smileym4n-collab/CoolCubeLM1875/CoolCubeLM1875kicad_pro/CoolCubeLM1875kicad_pro.kicad_pcb

## KiCad design CoolCubeLM1875kicad_pro/CoolCubeLM1875kicad_pro.kicad_pcb (2026-08-13)

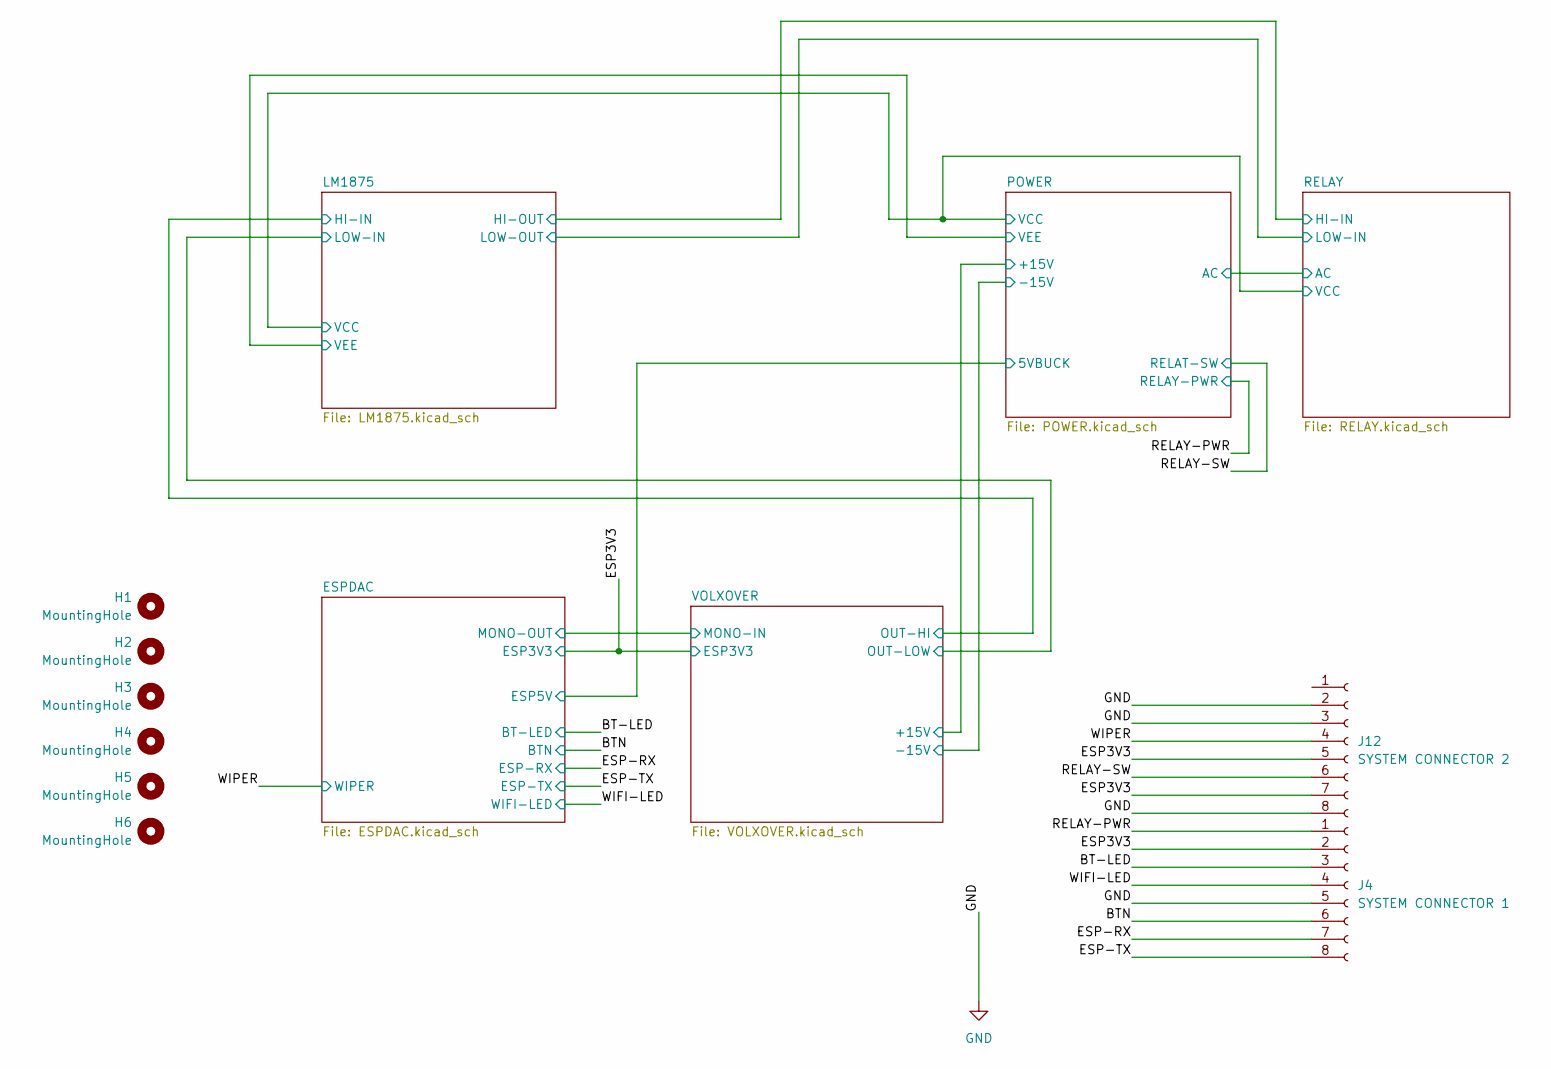
[picture p1: schematic CoolCubeLM1875kicad_pro.kicad_sch]

Parts:
H1, H2, H3, H4, H5, H6: MountingHole; MountingHole_4mm
J4: SYSTEM CONNECTOR 1; JST_XH_B8B-XH-A_1x08_P2.50mm_Vertical
J12: SYSTEM CONNECTOR 2; JST_XH_B8B-XH-A_1x08_P2.50mm_Vertical

Connections:
/BT-LED: J4.3; also elsewhere on the board
/BTN: J4.6; also elsewhere on the board
/ESP3V3: J4.2, J12.5, J12.7; also elsewhere on the board
/ESP-RX: J4.7; also elsewhere on the board
/ESP-TX: J4.8; also elsewhere on the board
/RELAY-PWR: J4.1; also elsewhere on the board
/RELAY-SW: J12.6; also elsewhere on the board
/WIFI-LED: J4.4; also elsewhere on the board
/WIPER: J12.4; also elsewhere on the board
GND: J4.5, J12.2, J12.3, J12.8; also elsewhere on the board

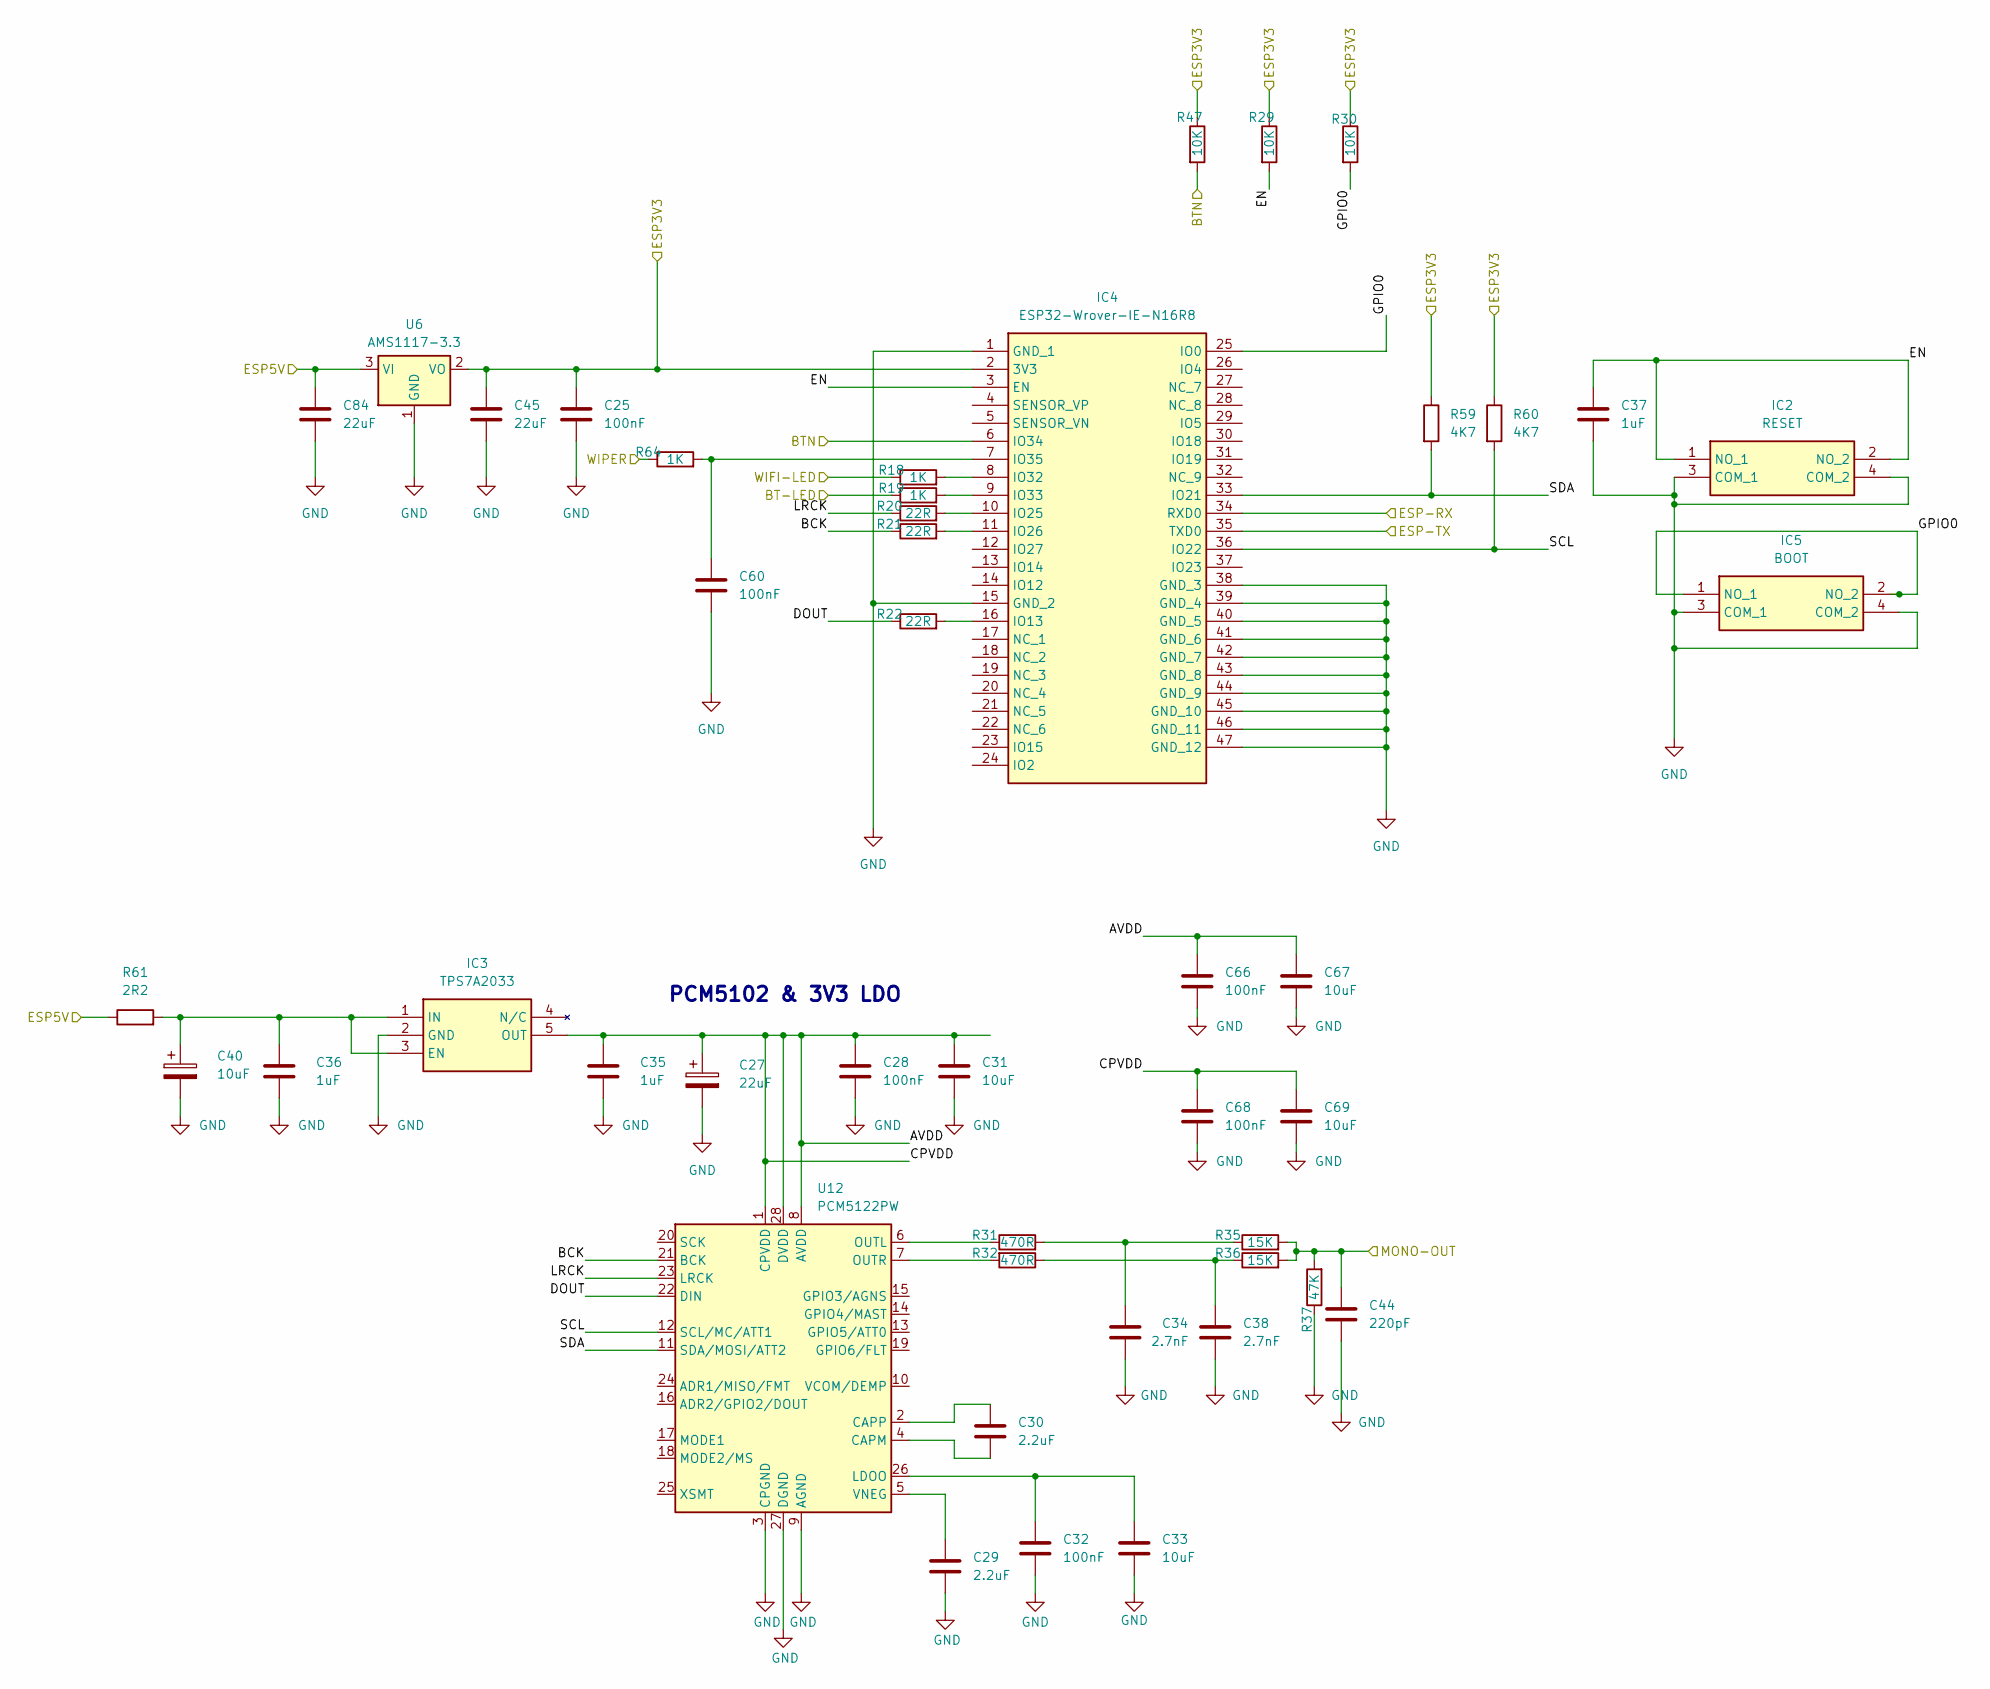
[picture p2: schematic ESPDAC.kicad_sch]

Parts:
C25, C28, C32, C60, C66, C68: 100nF; C_1206_3216Metric_Pad1.33x1.80mm_HandSolder
C27: 22uF; CP_Radial_D5.0mm_P2.50mm
C29, C30: 2.2uF; C_0805_2012Metric_Pad1.18x1.45mm_HandSolder
C31, C67, C69: 10uF; C_0805_2012Metric_Pad1.18x1.45mm_HandSolder
C33: 10uF; C_1206_3216Metric_Pad1.33x1.80mm_HandSolder
C34, C38: 2.7nF; C_0805_2012Metric_Pad1.18x1.45mm_HandSolder
C35, C36, C37: 1uF; C_1206_3216Metric_Pad1.33x1.80mm_HandSolder
C40: 10uF; CP_Radial_D4.0mm_P1.50mm
C44: 220pF; C_0603_1608Metric_Pad1.08x0.95mm_HandSolder
C45, C84: 22uF; C_0805_2012Metric_Pad1.18x1.45mm_HandSolder
IC2: RESET; TS026650BK100SCRD; Mouser Part Number 179-TS026650BK100SCR
IC3: TPS7A2033; SOT95P280X145-5N; Mouser Part Number 595-TPS7A2033PDBVR
IC4: ESP32-Wrover-IE-N16R8; ESP32-WROVER-IE-N16R8; Mouser Part Number 356-ESP32WRVIE2864UC
IC5: BOOT; TS026650BK100SCRD; Mouser Part Number 179-TS026650BK100SCR
R18, R19, R64: 1K; R_0805_2012Metric_Pad1.20x1.40mm_HandSolder
R20, R21, R22: 22R; R_0603_1608Metric_Pad0.98x0.95mm_HandSolder
R29, R30, R47: 10K; R_0603_1608Metric_Pad0.98x0.95mm_HandSolder
R31, R32: 470R; R_0805_2012Metric_Pad1.20x1.40mm_HandSolder
R35, R36: 15K; R_0805_2012Metric_Pad1.20x1.40mm_HandSolder
R37: 47K; R_0805_2012Metric_Pad1.20x1.40mm_HandSolder
R59, R60: 4K7; R_0805_2012Metric_Pad1.20x1.40mm_HandSolder
R61: 2R2; R_0805_2012Metric_Pad1.20x1.40mm_HandSolder
U6: AMS1117-3.3; SOT-223-3_TabPin2
U12: PCM5122PW; TSSOP-28_4.4x9.7mm_P0.65mm

Connections:
/BT-LED: R19.1; also elsewhere on the board
/BTN: IC4.6 (IO34), R47.2; also elsewhere on the board
/ESP3V3: C25.1, C45.1, IC4.2 (3V3), R29.1, R30.1, R47.1, R59.1, R60.1, U6.2 (VO); also elsewhere on the board
/ESP-RX: IC4.34 (RXD0); also elsewhere on the board
/ESP-TX: IC4.35 (TXD0); also elsewhere on the board
/ESPDAC/AVDD: C27.1, C28.1, C31.1, C35.1, C66.1, C67.1, C68.1, C69.1, IC3.5 (OUT), U12.1 (CPVDD), U12.8 (AVDD), U12.28 (DVDD)
/ESPDAC/BCK: R21.1, U12.21 (BCK)
/ESPDAC/DOUT: R22.1, U12.22 (DIN)
/ESPDAC/EN: C37.1, IC2.1 (NO_1), IC2.2 (NO_2), IC4.3 (EN), R29.2
/ESPDAC/ESP5V: C84.1, R61.1, U6.3 (VI); also elsewhere on the board
/ESPDAC/GPIO0: IC4.25 (IO0), IC5.1 (NO_1), IC5.2 (NO_2), R30.2
/ESPDAC/LRCK: R20.1, U12.23 (LRCK)
/ESPDAC/MONO-OUT: C44.1, R35.2, R36.2, R37.2; also elsewhere on the board
/ESPDAC/SCL: IC4.36 (IO22), R60.2, U12.12 (SCL/MC/ATT1)
/ESPDAC/SDA: IC4.33 (IO21), R59.2, U12.11 (SDA/MOSI/ATT2)
/WIFI-LED: R18.1; also elsewhere on the board
/WIPER: R64.1; also elsewhere on the board
GND: C25.2, C27.2, C28.2, C29.2, C31.2, C32.2, C33.2, C34.2, C35.2, C36.2, C37.2, C38.2, C40.2, C44.2, C45.2, C60.2, C66.2, C67.2, C68.2, C69.2, C84.2, IC2.3 (COM_1), IC2.4 (COM_2), IC3.2 (GND), IC4.1 (GND_1), IC4.15 (GND_2), IC4.38 (GND_3), IC4.39 (GND_4), IC4.40 (GND_5), IC4.41 (GND_6), IC4.42 (GND_7), IC4.43 (GND_8), IC4.44 (GND_9), IC4.45 (GND_10), IC4.46 (GND_11), IC4.47 (GND_12), IC5.3 (COM_1), IC5.4 (COM_2), R37.1, U6.1 (GND), U12.3 (CPGND), U12.9 (AGND), U12.27 (DGND); also elsewhere on the board
unnamed: C34.1, R31.2, R35.1
unnamed: C38.1, R32.1, R36.1
unnamed: C36.1, C40.1, IC3.1 (IN), IC3.3 (EN), R61.2
unnamed: IC4.16 (IO13), R22.2
unnamed: IC4.10 (IO25), R20.2
unnamed: IC4.11 (IO26), R21.2
unnamed: IC4.8 (IO32), R18.2
unnamed: IC4.9 (IO33), R19.2
unnamed: C60.1, IC4.7 (IO35), R64.2
unnamed: C30.2, U12.4 (CAPM)
unnamed: C30.1, U12.2 (CAPP)
unnamed: C32.1, C33.1, U12.26 (LDOO)
unnamed: R31.1, U12.6 (OUTL)
unnamed: R32.2, U12.7 (OUTR)
unnamed: C29.1, U12.5 (VNEG)

Notes on the sheet:
PCM5102 & 3V3 LDO

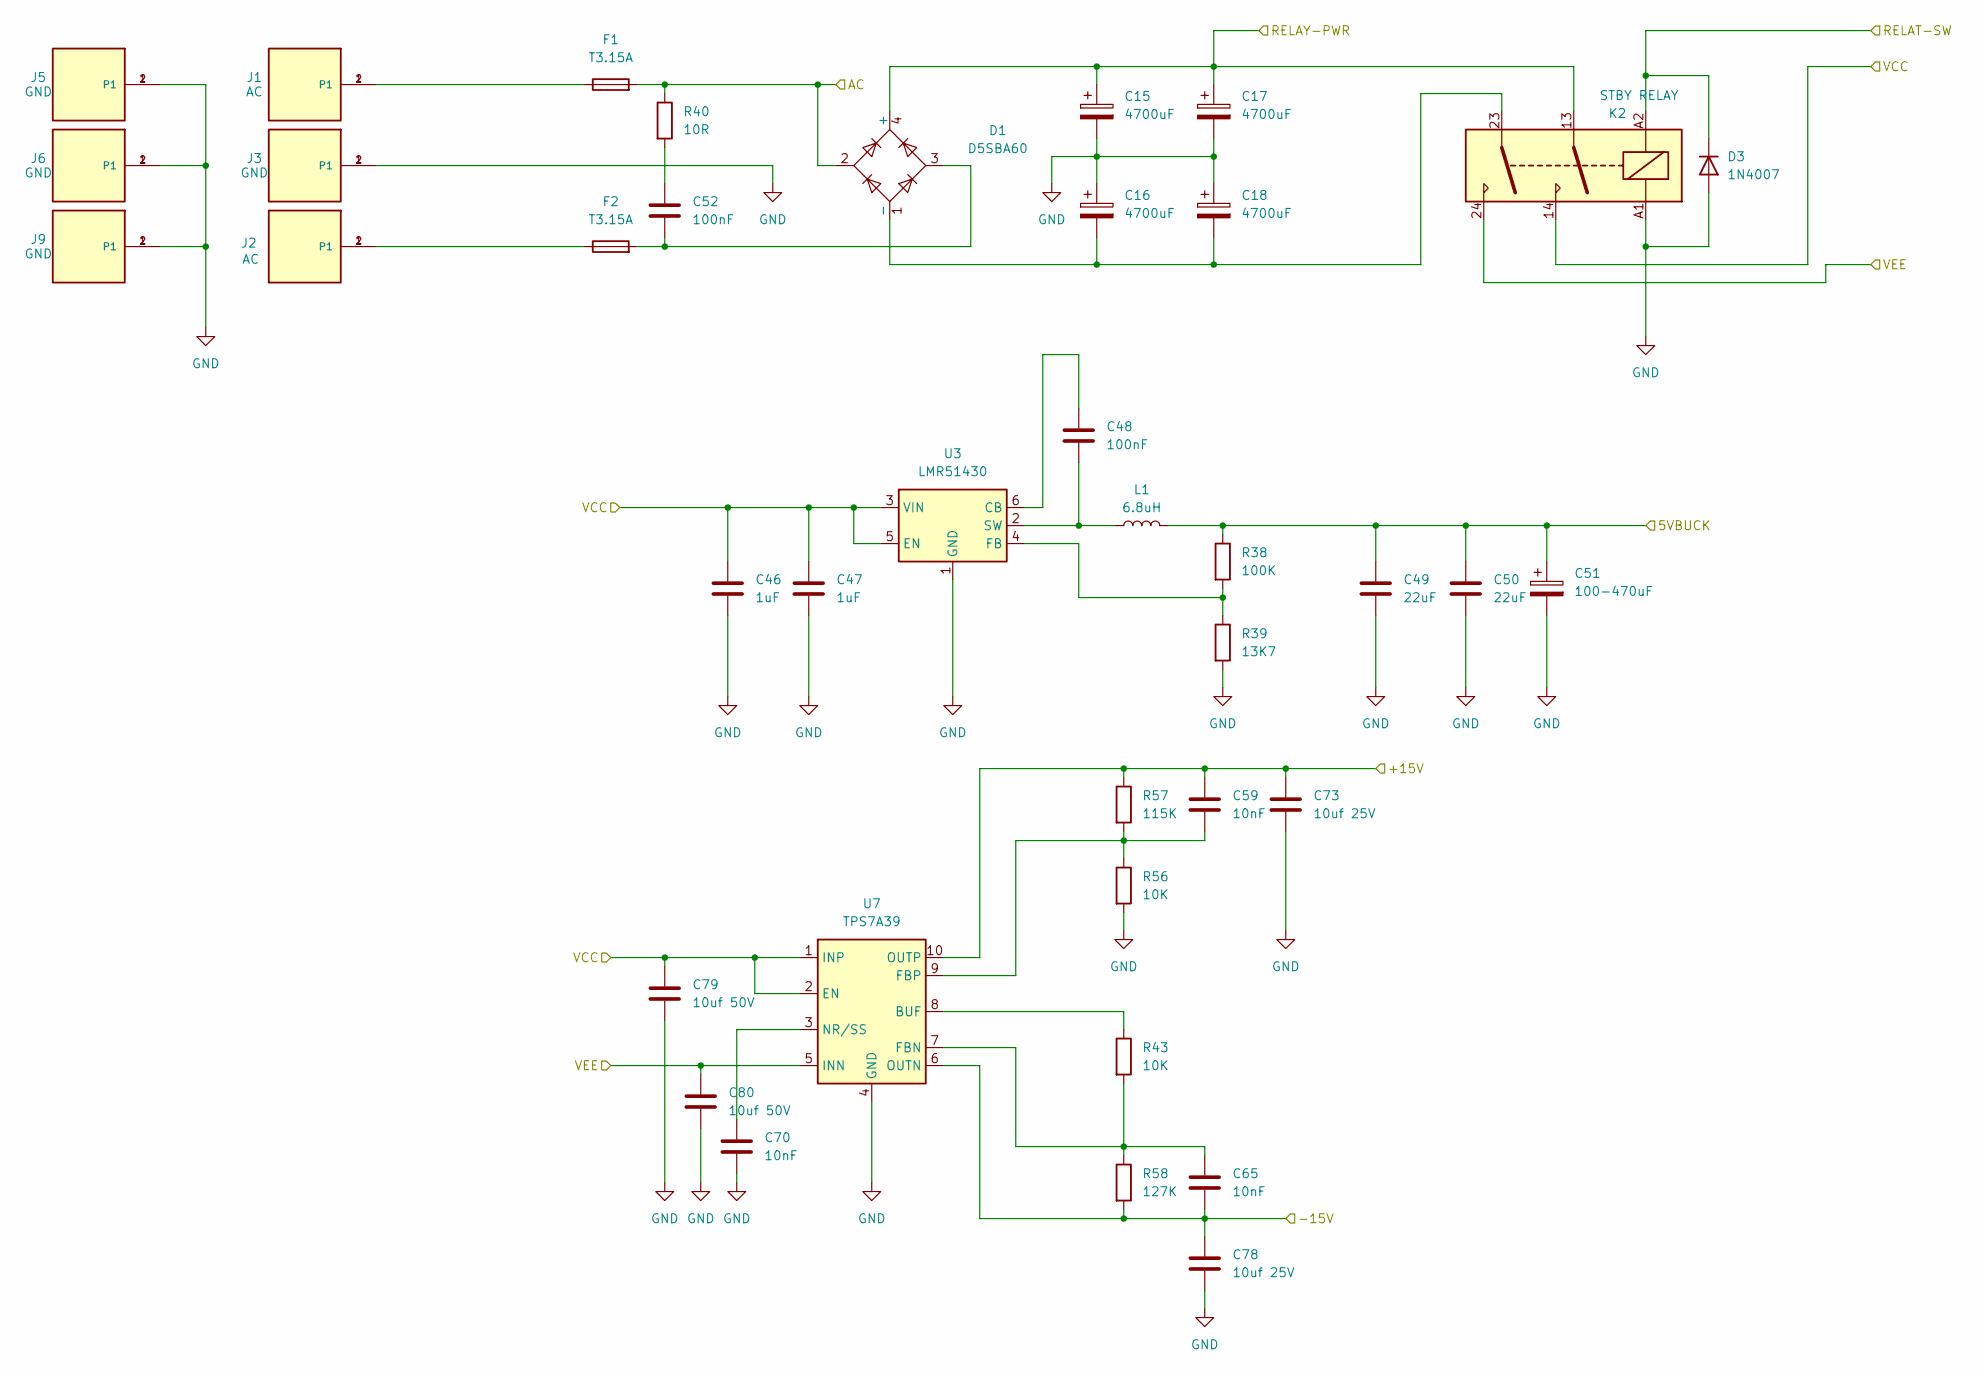
[picture p3: schematic POWER.kicad_sch]

Parts:
C15, C16, C17, C18: 4700uF; CP_Radial_D22.0mm_P10.00mm_SnapIn
C46, C47: 1uF; C_1206_3216Metric_Pad1.33x1.80mm_HandSolder
C48: 100nF; C_1206_3216Metric_Pad1.33x1.80mm_HandSolder
C49, C50: 22uF; C_1206_3216Metric_Pad1.33x1.80mm_HandSolder
C51: 100-470uF; CP_Radial_D8.0mm_P3.50mm
C52: 100nF; C_Rect_L18.0mm_W5.0mm_P15.00mm_FKS3_FKP3
C59, C65, C70: 10nF; C_0805_2012Metric_Pad1.18x1.45mm_HandSolder
C73, C78: 10uf 25V; C_1206_3216Metric_Pad1.33x1.80mm_HandSolder
C79, C80: 10uf 50V; C_1206_3216Metric_Pad1.33x1.80mm_HandSolder
D1: D5SBA60; Diode_Bridge_32.0x5.6x17.0mm_P10.0mm_P7.5mm
D3: 1N4007; D_DO-41_SOD81_P10.16mm_Horizontal
F1, F2: T3.15A; Fuseholder_Cylinder-5x20mm_Schurter_0031_8201_Horizontal_Op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
J1, J2: AC; TE_62409-1; PART_DESCRIPTION CONN QC TAB 0.250 SOLDER
J3, J5, J6, J9: GND; TE_62409-1; PART_DESCRIPTION CONN QC TAB 0.250 SOLDER
K2: STBY RELAY; Relay_DPST_Omron_G2RL-2A
L1: 6.8uH; SRP6030WA-6R8M
R38: 100K; R_0805_2012Metric_Pad1.20x1.40mm_HandSolder
R39: 13K7; R_0805_2012Metric_Pad1.20x1.40mm_HandSolder
R40: 10R; R_Axial_DIN0617_L17.0mm_D6.0mm_P20.32mm_Horizontal
R43, R56: 10K; R_0805_2012Metric_Pad1.20x1.40mm_HandSolder
R57: 115K; R_0805_2012Metric_Pad1.20x1.40mm_HandSolder
R58: 127K; R_0805_2012Metric_Pad1.20x1.40mm_HandSolder
U3: LMR51430; SOT-23-6_Handsoldering
U7: TPS7A39; Texas_S-PVSON-N10_ThermalVias

Connections:
/ESPDAC/ESP5V: C49.1, C50.1, C51.1, L1.2, R38.1; also elsewhere on the board
/LM1875/VCC: C46.1, C47.1, C79.1, K2.14, U3.3 (VIN), U3.5 (EN), U7.1 (INP), U7.2 (EN); also elsewhere on the board
/LM1875/VEE: C80.1, K2.24, U7.5 (INN); also elsewhere on the board
/POWER/+15V: C59.1, C73.1, R57.1, U7.10 (OUTP); also elsewhere on the board
/POWER/-15V: C65.2, C78.1, R58.2, U7.6 (OUTN); also elsewhere on the board
/POWER/AC: D1.2, F1.2, R40.1; also elsewhere on the board
/RELAY-PWR: C15.1, C17.1, D1.4 (+), K2.13; also elsewhere on the board
/RELAY-SW: D3.1 (K), K2.A2; also elsewhere on the board
GND: C15.2, C16.1, C17.2, C18.1, C46.2, C47.2, C49.2, C50.2, C51.2, C70.2, C73.2, C78.2, C79.2, C80.2, D3.2 (A), J3.1, J3.2 (P1), J5.1, J5.2 (P1), J6.1, J6.2 (P1), J9.1, J9.2 (P1), K2.A1, R39.2, R56.2, U3.1 (GND), U7.4 (GND), U7.11 (GND); also elsewhere on the board
unnamed: C52.1, R40.2
unnamed: C52.2, D1.3, F2.2
unnamed: C16.2, C18.2, D1.1 (-), K2.23
unnamed: F1.1, J1.1, J1.2 (P1)
unnamed: F2.1, J2.1, J2.2 (P1)
unnamed: C48.1, U3.6 (CB)
unnamed: R38.2, R39.1, U3.4 (FB)
unnamed: C48.2, L1.1, U3.2 (SW)
unnamed: R43.1, U7.8 (BUF)
unnamed: C65.1, R43.2, R58.1, U7.7 (FBN)
unnamed: C59.2, R56.1, R57.2, U7.9 (FBP)
unnamed: C70.1, U7.3 (NR/SS)

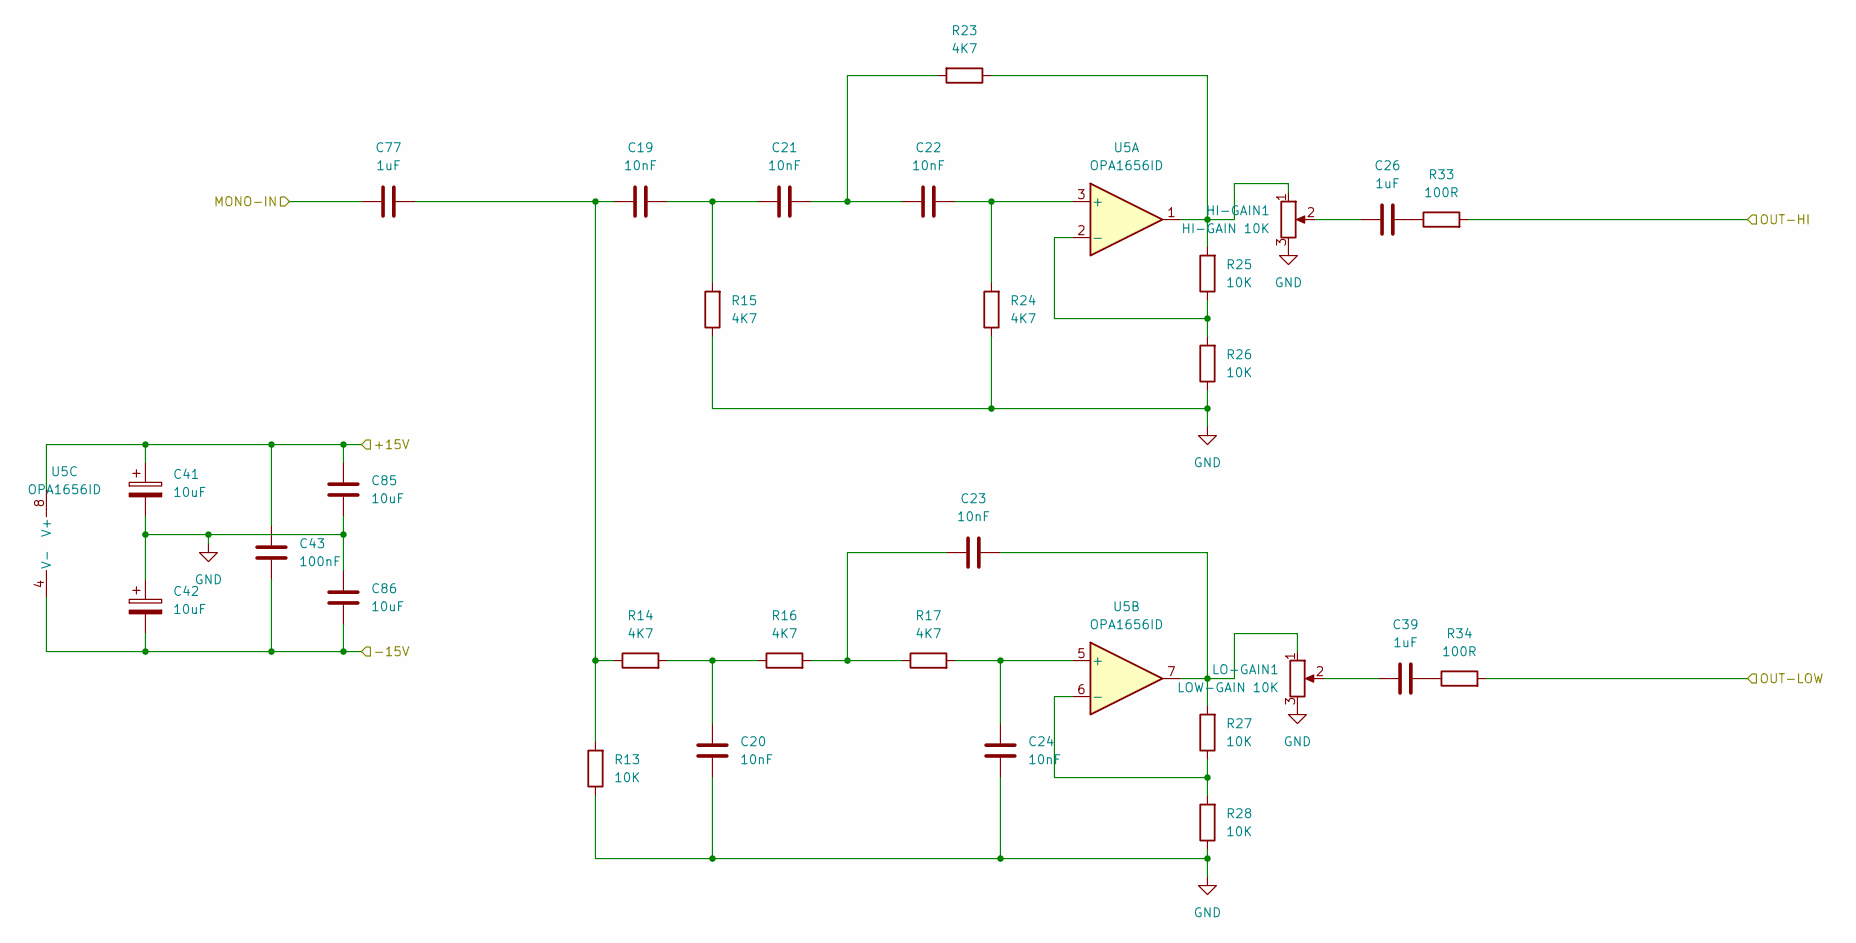
[picture p4: schematic VOLXOVER.kicad_sch]

Parts:
C19, C20, C21, C22, C23, C24: 10nF; C_0805_2012Metric_Pad1.18x1.45mm_HandSolder
C26, C39, C77: 1uF; C_Rect_L7.2mm_W5.5mm_P5.00mm_FKS2_FKP2_MKS2_MKP2
C41, C42: 10uF; CP_Radial_D5.0mm_P2.50mm
C43: 100nF; C_1206_3216Metric_Pad1.33x1.80mm_HandSolder
C85, C86: 10uF; C_1206_3216Metric_Pad1.33x1.80mm_HandSolder
HI-GAIN1: HI-GAIN 10K; Potentiometer_Vishay_T93YA_Vertical
LO-GAIN1: LOW-GAIN 10K; Potentiometer_Vishay_T93YA_Vertical
R13, R25, R26, R27, R28: 10K; R_0805_2012Metric_Pad1.20x1.40mm_HandSolder
R14, R15, R16, R17, R23, R24: 4K7; R_0805_2012Metric_Pad1.20x1.40mm_HandSolder
R33, R34: 100R; R_0805_2012Metric_Pad1.20x1.40mm_HandSolder
U5: OPA1656ID; SOIC-8_3.9x4.9mm_P1.27mm

Connections:
/ESPDAC/MONO-OUT: C77.1; also elsewhere on the board
/LM1875/HI-IN: R33.2; also elsewhere on the board
/LM1875/LOW-IN: R34.2; also elsewhere on the board
/POWER/+15V: C41.1, C43.1, C85.1, U5.8 (V+); also elsewhere on the board
/POWER/-15V: C42.2, C43.2, C86.2, U5.4 (V-); also elsewhere on the board
GND: C20.1, C24.1, C41.2, C42.1, C85.2, C86.1, HI-GAIN1.3, LO-GAIN1.3, R13.1, R15.1, R24.1, R26.1, R28.1; also elsewhere on the board
unnamed: C19.1, C77.2, R13.2, R14.1
unnamed: C19.2, C21.1, R15.2
unnamed: C20.2, R14.2, R16.1
unnamed: C21.2, C22.1, R23.2
unnamed: C23.1, R16.2, R17.1
unnamed: C23.2, LO-GAIN1.1, R27.2, U5.7
unnamed: C26.1, HI-GAIN1.2
unnamed: C26.2, R33.1
unnamed: C39.1, LO-GAIN1.2
unnamed: C39.2, R34.1
unnamed: HI-GAIN1.1, R23.1, R25.2, U5.1
unnamed: C22.2, R24.2, U5.3 (+)
unnamed: R25.1, R26.2, U5.2 (-)
unnamed: C24.2, R17.2, U5.5 (+)
unnamed: R27.1, R28.2, U5.6 (-)

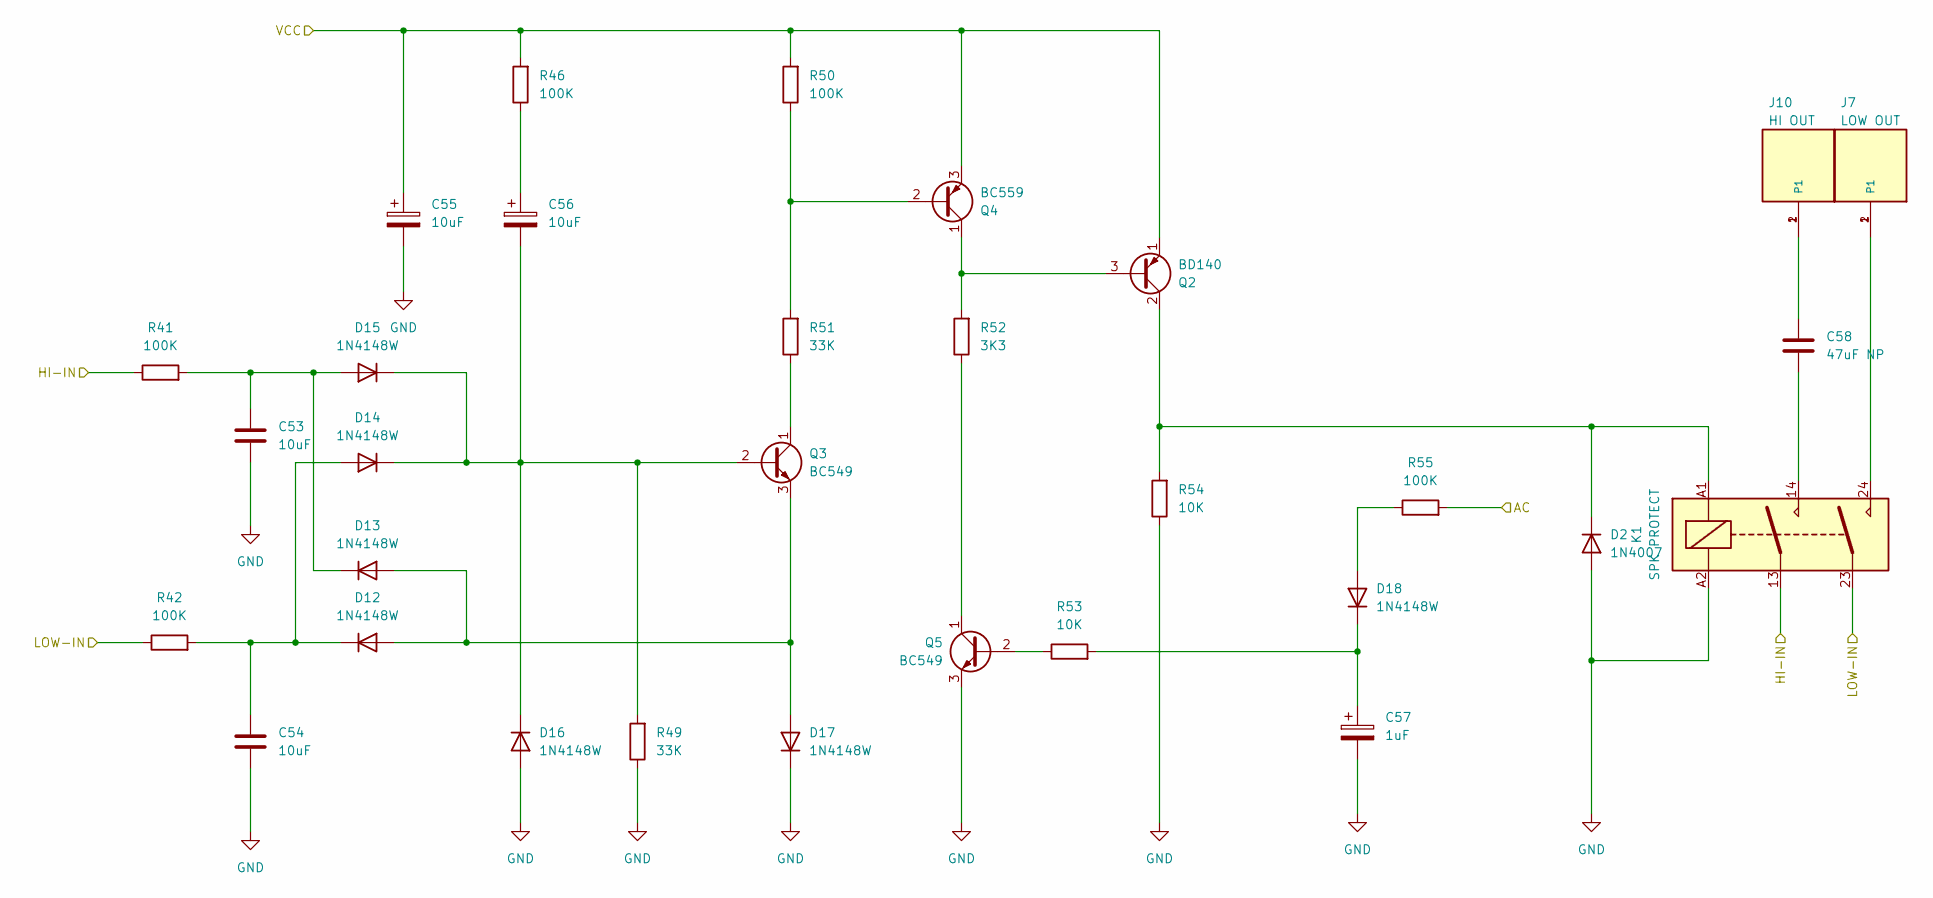
[picture p5: schematic RELAY.kicad_sch]

Parts:
C53, C54: 10uF; C_Radial_D6.3mm_H7.0mm_P2.50mm
C55, C56: 10uF; CP_Radial_D5.0mm_P2.00mm
C57: 1uF; CP_Radial_D5.0mm_P2.00mm
C58: 47uF NP; C_Radial_D10.0mm_H20.0mm_P5.00mm
D2: 1N4007; D_DO-41_SOD81_P10.16mm_Horizontal
D12, D13, D14, D15, D16, D17, D18: 1N4148W; D_SOD-123
J7: LOW OUT; TE_62409-1; PART_DESCRIPTION CONN QC TAB 0.250 SOLDER
J10: HI OUT; TE_62409-1; PART_DESCRIPTION CONN QC TAB 0.250 SOLDER
K1: SPK PROTECT; Relay_DPST_Omron_G2RL-2A
Q2: BD140; TO-126-3_Vertical
Q3, Q5: BC549; TO-92L_Inline_Wide
Q4: BC559; TO-92L_Inline_Wide
R41, R42, R46, R50, R55: 100K; R_0805_2012Metric_Pad1.20x1.40mm_HandSolder
R49, R51: 33K; R_0805_2012Metric_Pad1.20x1.40mm_HandSolder
R52: 3K3; R_0805_2012Metric_Pad1.20x1.40mm_HandSolder
R53, R54: 10K; R_0805_2012Metric_Pad1.20x1.40mm_HandSolder

Connections:
/LM1875/HI-OUT: K1.13, R41.1; also elsewhere on the board
/LM1875/LOW-OUT: K1.23, R42.1; also elsewhere on the board
/LM1875/VCC: C55.1, Q2.1 (E), Q4.3 (E), R46.2, R50.2; also elsewhere on the board
/POWER/AC: R55.2; also elsewhere on the board
GND: C53.1, C54.1, C55.2, C57.2, D2.2 (A), D16.2 (A), D17.1 (K), K1.A2, Q5.3 (E), R49.1, R54.1; also elsewhere on the board
unnamed: C56.1, R46.1
unnamed: C58.1, J10.1, J10.2 (P1)
unnamed: C58.2, K1.14
unnamed: D2.1 (K), K1.A1, Q2.2 (C), R54.2
unnamed: D12.2 (A), D13.2 (A), D17.2 (A), Q3.3 (E)
unnamed: C54.2, D12.1 (K), D14.2 (A), R42.2
unnamed: C53.2, D13.1 (K), D15.2 (A), R41.2
unnamed: C56.2, D14.1 (K), D15.1 (K), D16.1 (K), Q3.2 (B), R49.2
unnamed: D18.2 (A), R55.1
unnamed: C57.1, D18.1 (K), R53.2
unnamed: J7.1, J7.2 (P1), K1.24
unnamed: Q2.3 (B), Q4.1 (C), R52.2
unnamed: Q3.1 (C), R51.1
unnamed: Q4.2 (B), R50.1, R51.2
unnamed: Q5.2 (B), R53.1
unnamed: Q5.1 (C), R52.1

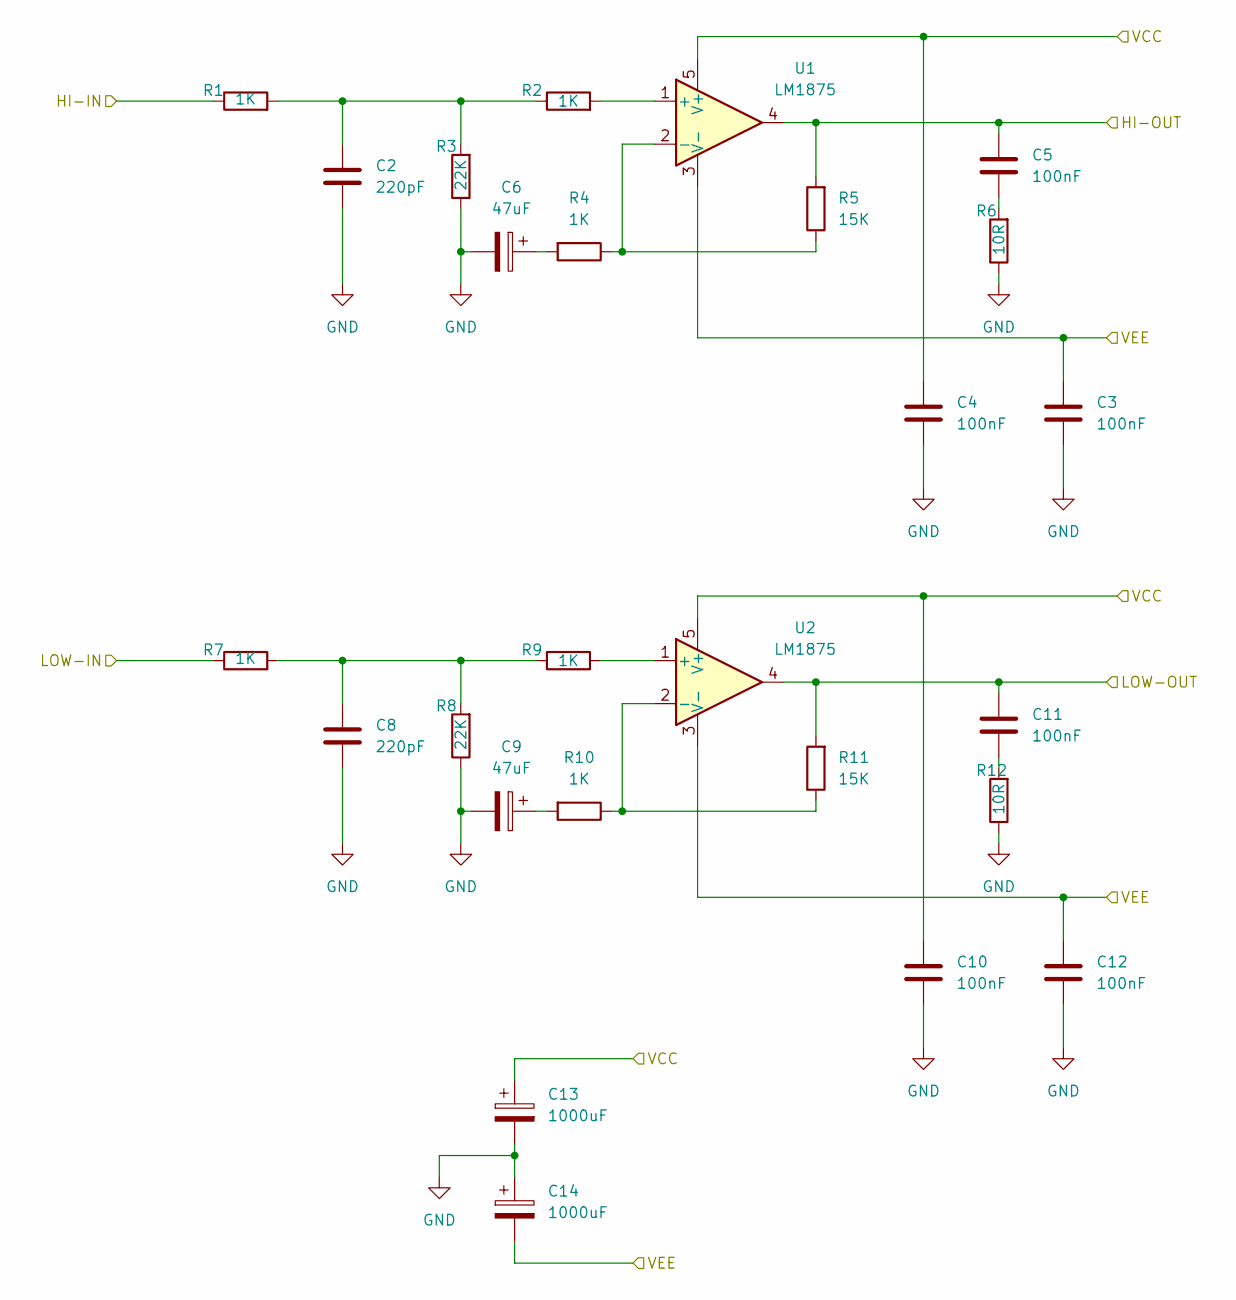
[picture p6: schematic LM1875.kicad_sch]

Parts:
C2, C8: 220pF; C_0805_2012Metric_Pad1.18x1.45mm_HandSolder
C3, C4, C10, C12: 100nF; C_1206_3216Metric_Pad1.33x1.80mm_HandSolder
C5, C11: 100nF; C_Rect_L7.2mm_W2.5mm_P5.00mm_FKS2_FKP2_MKS2_MKP2
C6, C9: 47uF; CP_Radial_D6.3mm_P2.50mm
C13, C14: 1000uF; CP_Radial_D12.5mm_P5.00mm
R1, R2, R4, R7, R9, R10: 1K; R_0805_2012Metric_Pad1.20x1.40mm_HandSolder
R3, R8: 22K; R_0805_2012Metric_Pad1.20x1.40mm_HandSolder
R5, R11: 15K; R_0805_2012Metric_Pad1.20x1.40mm_HandSolder
R6, R12: 10R; R_Axial_DIN0309_L9.0mm_D3.2mm_P12.70mm_Horizontal
U1, U2: LM1875; TO-220-5_P3.4x3.7mm_StaggerOdd_Lead3.8mm_Vertical

Connections:
/LM1875/HI-IN: R1.1; also elsewhere on the board
/LM1875/HI-OUT: C5.1, R5.2, U1.4; also elsewhere on the board
/LM1875/LOW-IN: R7.1; also elsewhere on the board
/LM1875/LOW-OUT: C11.1, R11.2, U2.4; also elsewhere on the board
/LM1875/VCC: C4.1, C10.1, C13.1, U1.5 (V+), U2.5 (V+); also elsewhere on the board
/LM1875/VEE: C3.1, C12.1, C14.2, U1.3 (V-), U2.3 (V-); also elsewhere on the board
GND: C2.2, C3.2, C4.2, C6.2, C8.2, C9.2, C10.2, C12.2, C13.2, C14.1, R3.1, R6.1, R8.1, R12.1; also elsewhere on the board
unnamed: C2.1, R1.2, R2.1, R3.2
unnamed: C5.2, R6.2
unnamed: C6.1, R4.2
unnamed: C8.1, R7.2, R8.2, R9.1
unnamed: C9.1, R10.2
unnamed: C11.2, R12.2
unnamed: R2.2, U1.1 (+)
unnamed: R4.1, R5.1, U1.2 (-)
unnamed: R9.2, U2.1 (+)
unnamed: R10.1, R11.1, U2.2 (-)

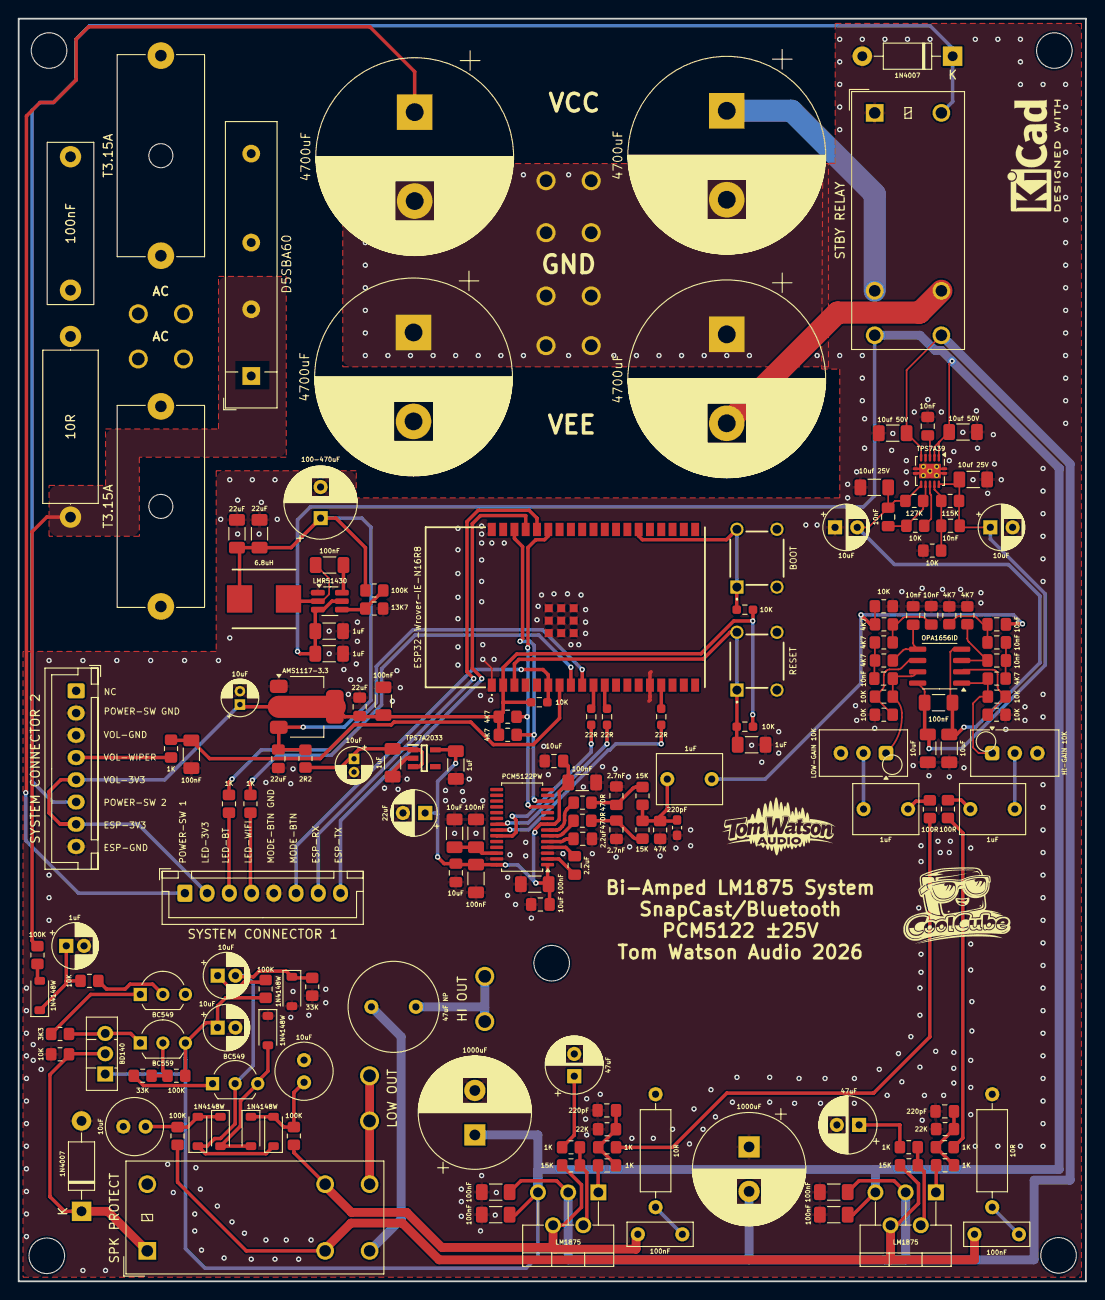
[picture p7: board CoolCubeLM1875kicad_pro.kicad_pcb from above]

Board: 2 copper layers, 120.0 x 142.0 mm, 180 parts (0 on the bottom side), 97 nets.

Other parts of the board:
C71: 10uF; CP_Radial_D4.0mm_P1.50mm

Their connections:
/ESP3V3: C71.1; also elsewhere on the board
GND: C71.2; also elsewhere on the board
