smileym4n-collab/CoolCubeLM1875/(commit log)

2026-07-29 more work
    [CoolCubeLM1875kicad_pro.kicad_pcb, CoolCubeLM1875kicad_pro.kicad_sch, ESPDAC.kicad_sch, LM1875.kicad_sch, POWER.kicad_sch, RELAY.kicad_sch, VOLXOVER.kicad_sch]
2026-08-10 final design
    [CoolCubeLM1875kicad_pro.kicad_pcb, CoolCubeLM1875kicad_pro.kicad_sch, ESPDAC.kicad_sch, POWER.kicad_sch, RELAY.kicad_sch, VOLXOVER.kicad_sch]
